navneet-krishna/Wireless_Lamp_Switch/fab/Receiver-3d-bottom.png

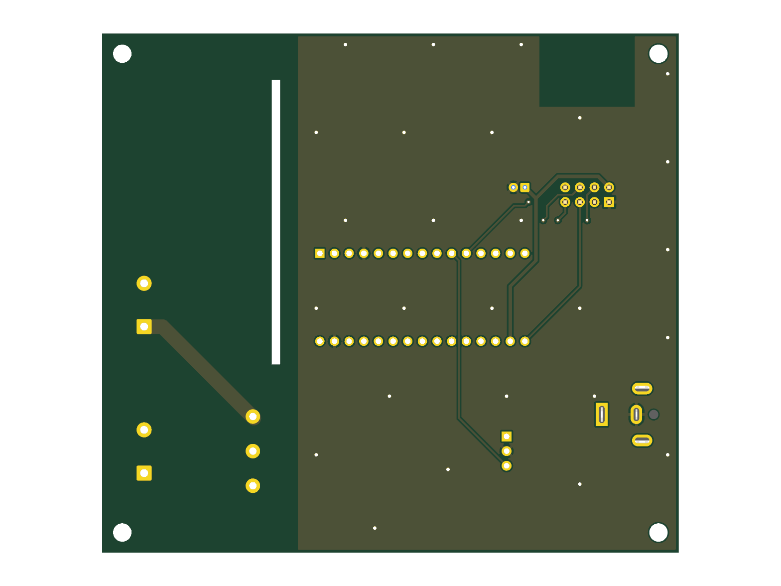
fab/Receiver-3d-bottom.png
