navneet-krishna/Wireless_Lamp_Switch/fab/Receiver-3d-top.png

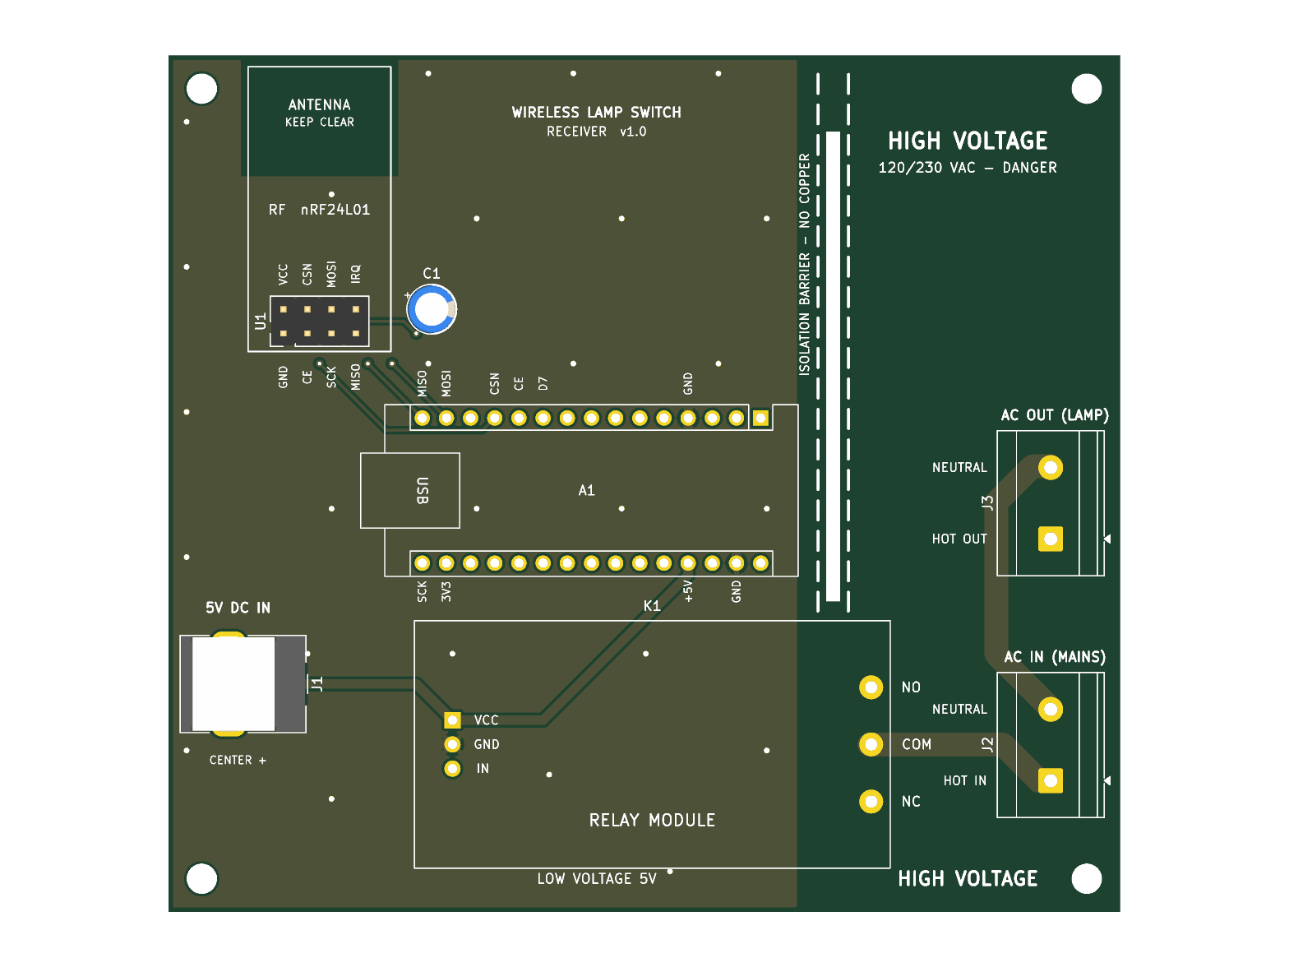
fab/Receiver-3d-top.png
