navneet-krishna/Wireless_Lamp_Switch/fab/Transmitter-3d-bottom.png

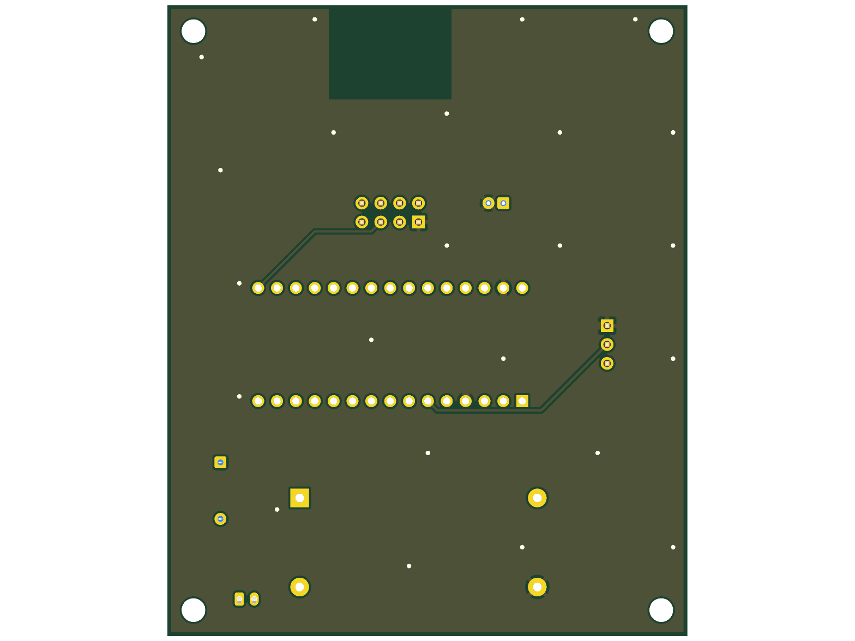
fab/Transmitter-3d-bottom.png
