navneet-krishna/Wireless_Lamp_Switch/fab/Transmitter-3d-top.png

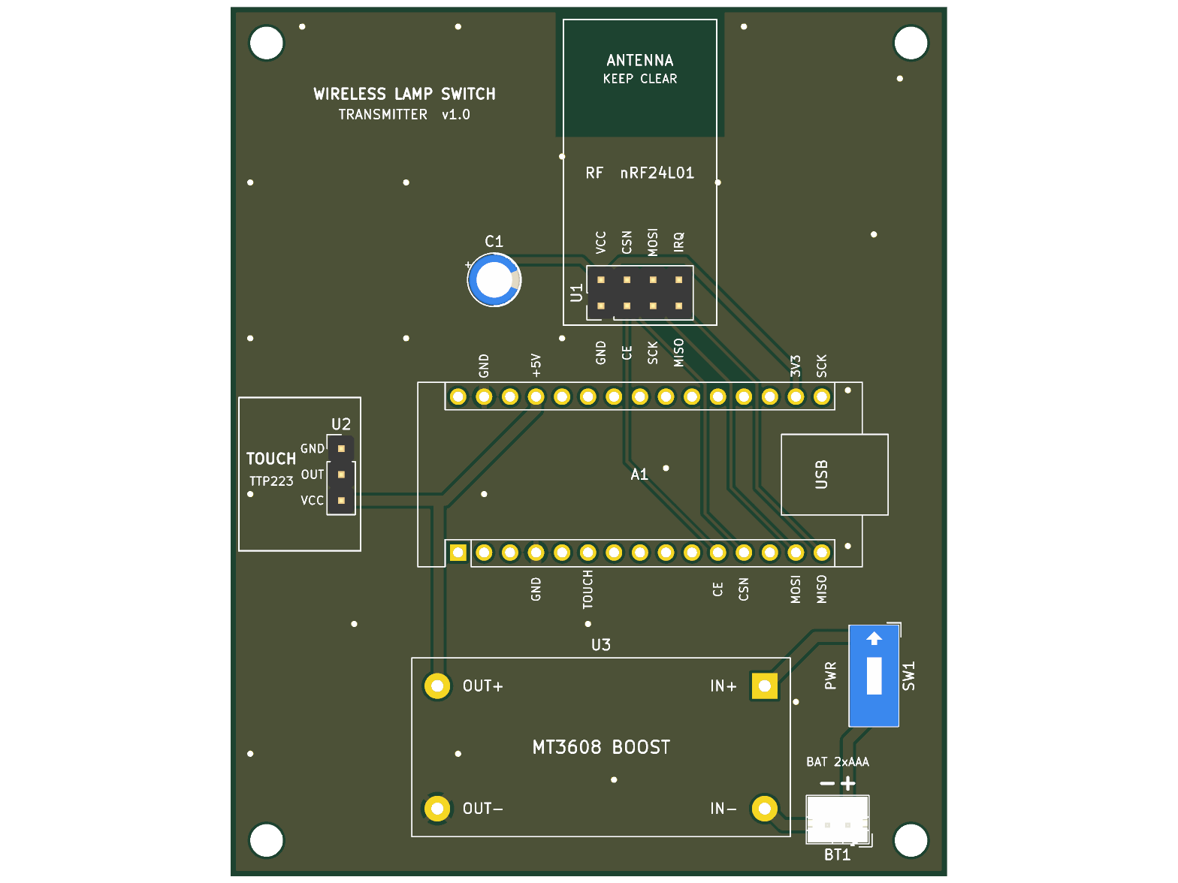
fab/Transmitter-3d-top.png
