navneet-krishna/Wireless_Lamp_Switch/fab/Receiver-schematic.pdf

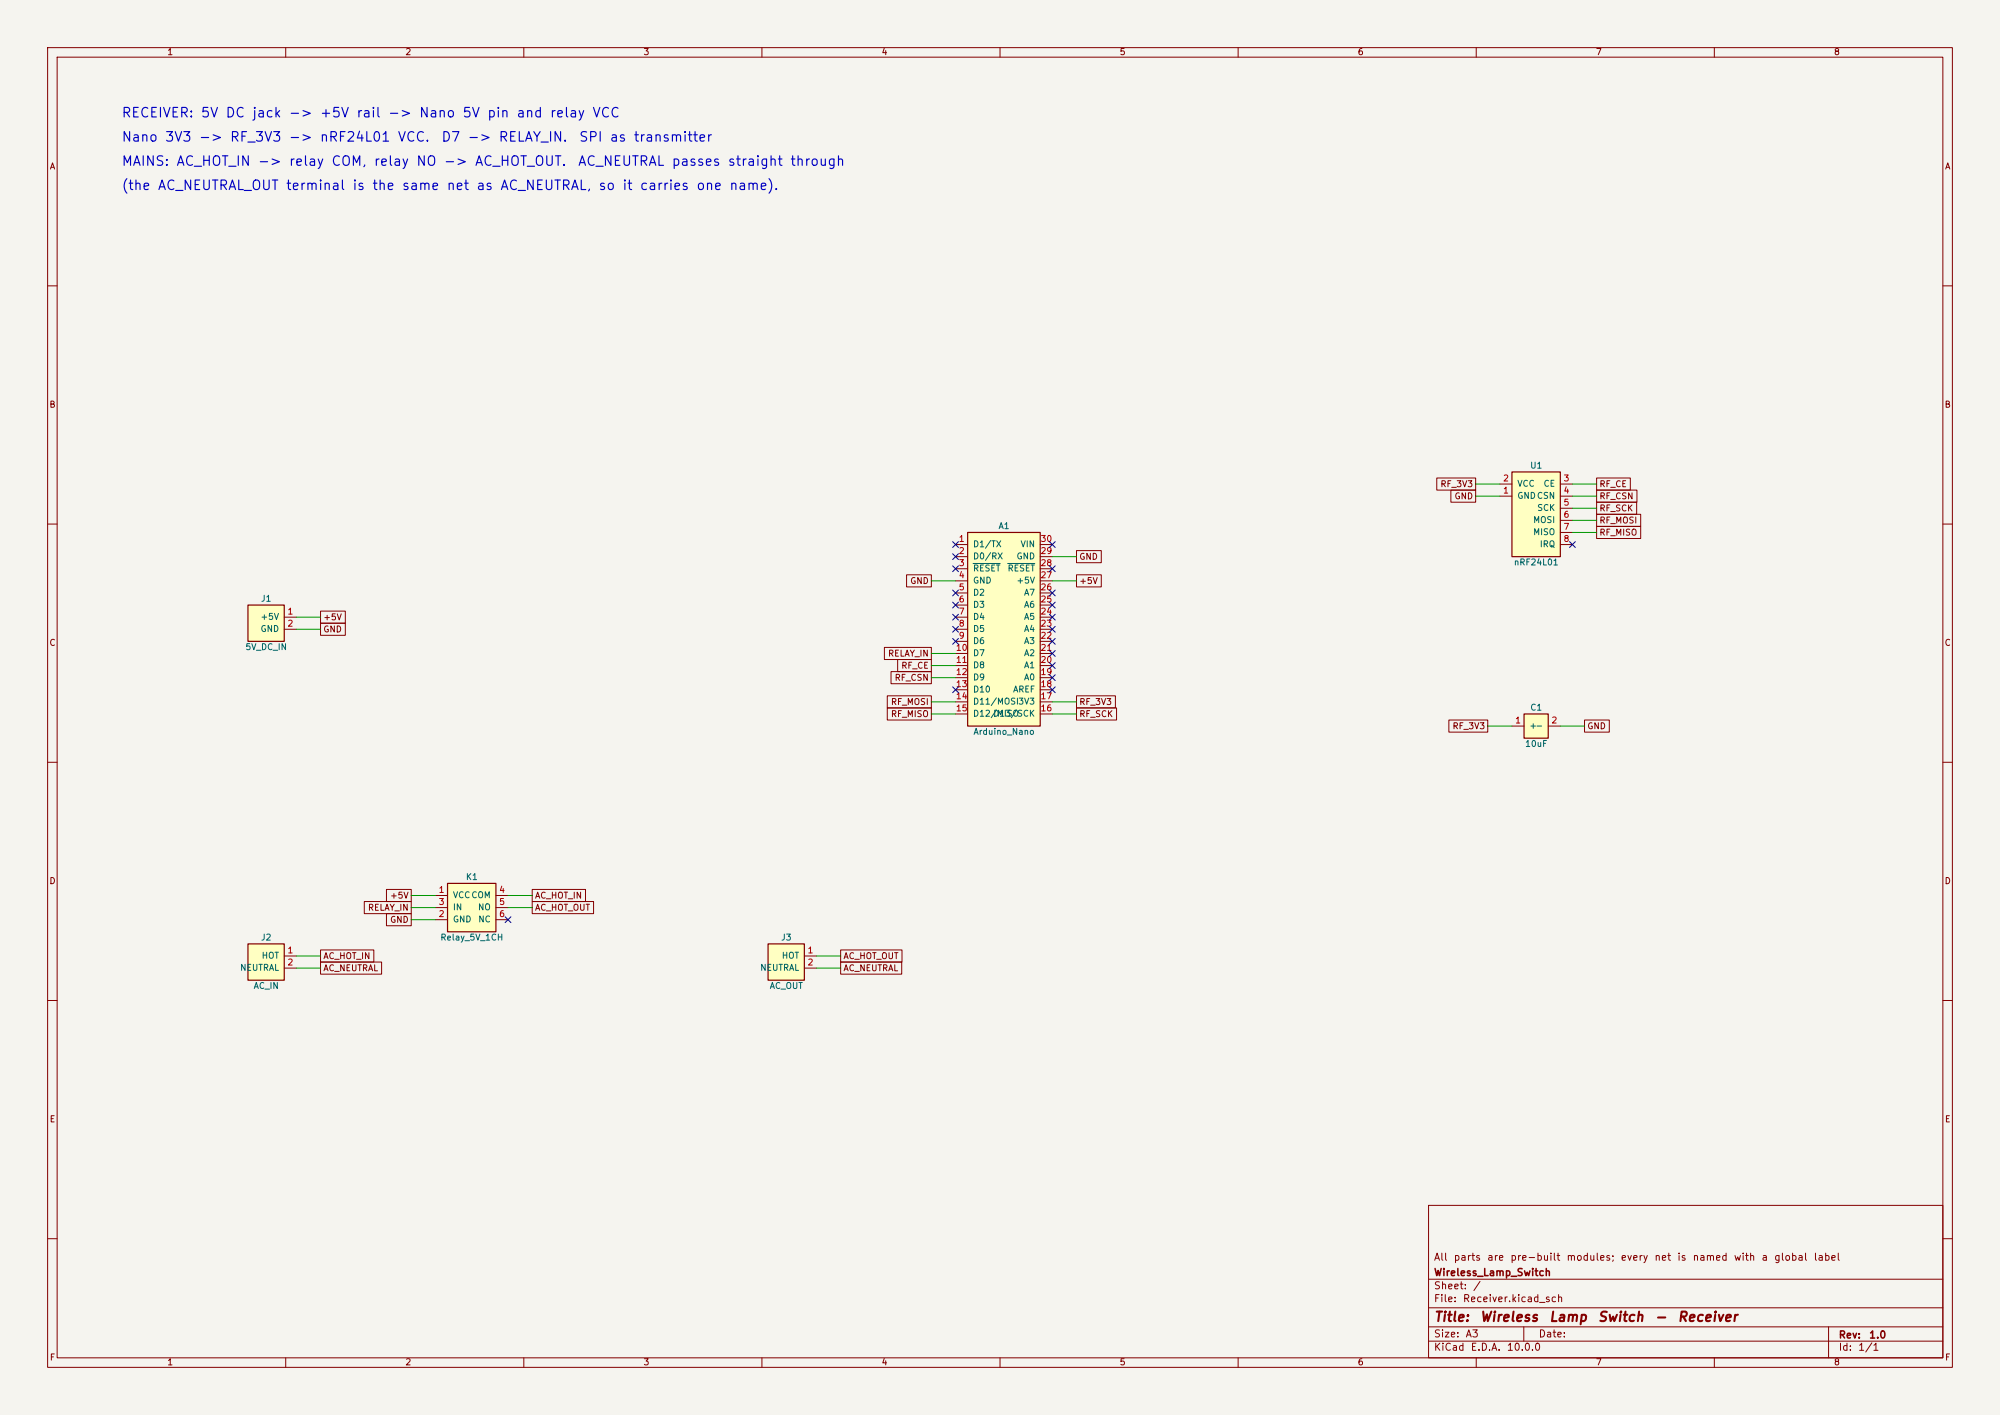
[picture p5: page 1]

RECEIVER: 5V DC jack -> +5V rail -> Nano 5V pin and relay VCC

All parts are pre-built modules; every net is named with a global label
Wireless_Lamp_Switch
Sheet: /
File: Receiver.kicad_sch
Title: Wireless Lamp Switch - Receiver

Size: A3 | Rev: 1.0 | F Date:
KiCad E.D.A. 10.0.0 | Id: 1/1
