navneet-krishna/Wireless_Lamp_Switch/fab/Receiver-top-assembly.pdf

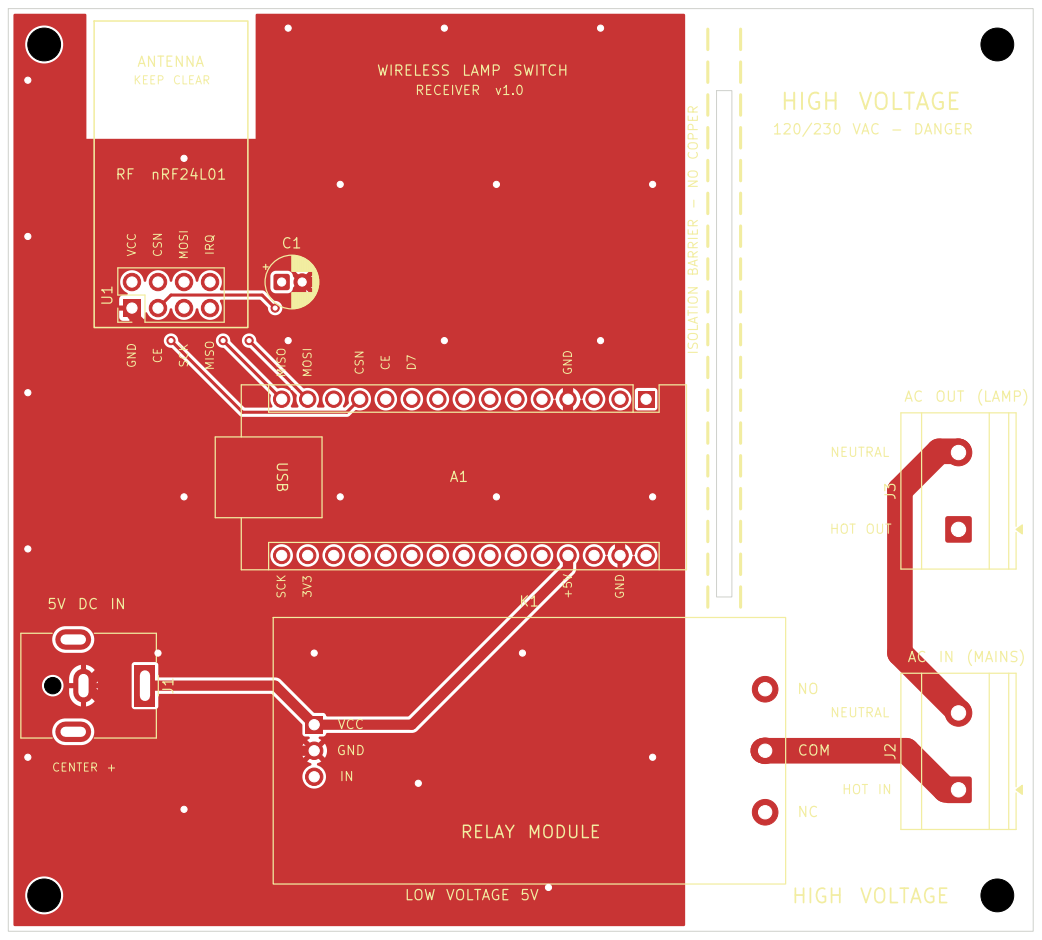
[picture p6: page 1]

ANTENNA RF nRF24L01
AC OUT (LAMP) AC IN (MAINS) HIGH VOLTAGE HIGH VOLTAGE
