navneet-krishna/Wireless_Lamp_Switch/fab/Transmitter-schematic.pdf

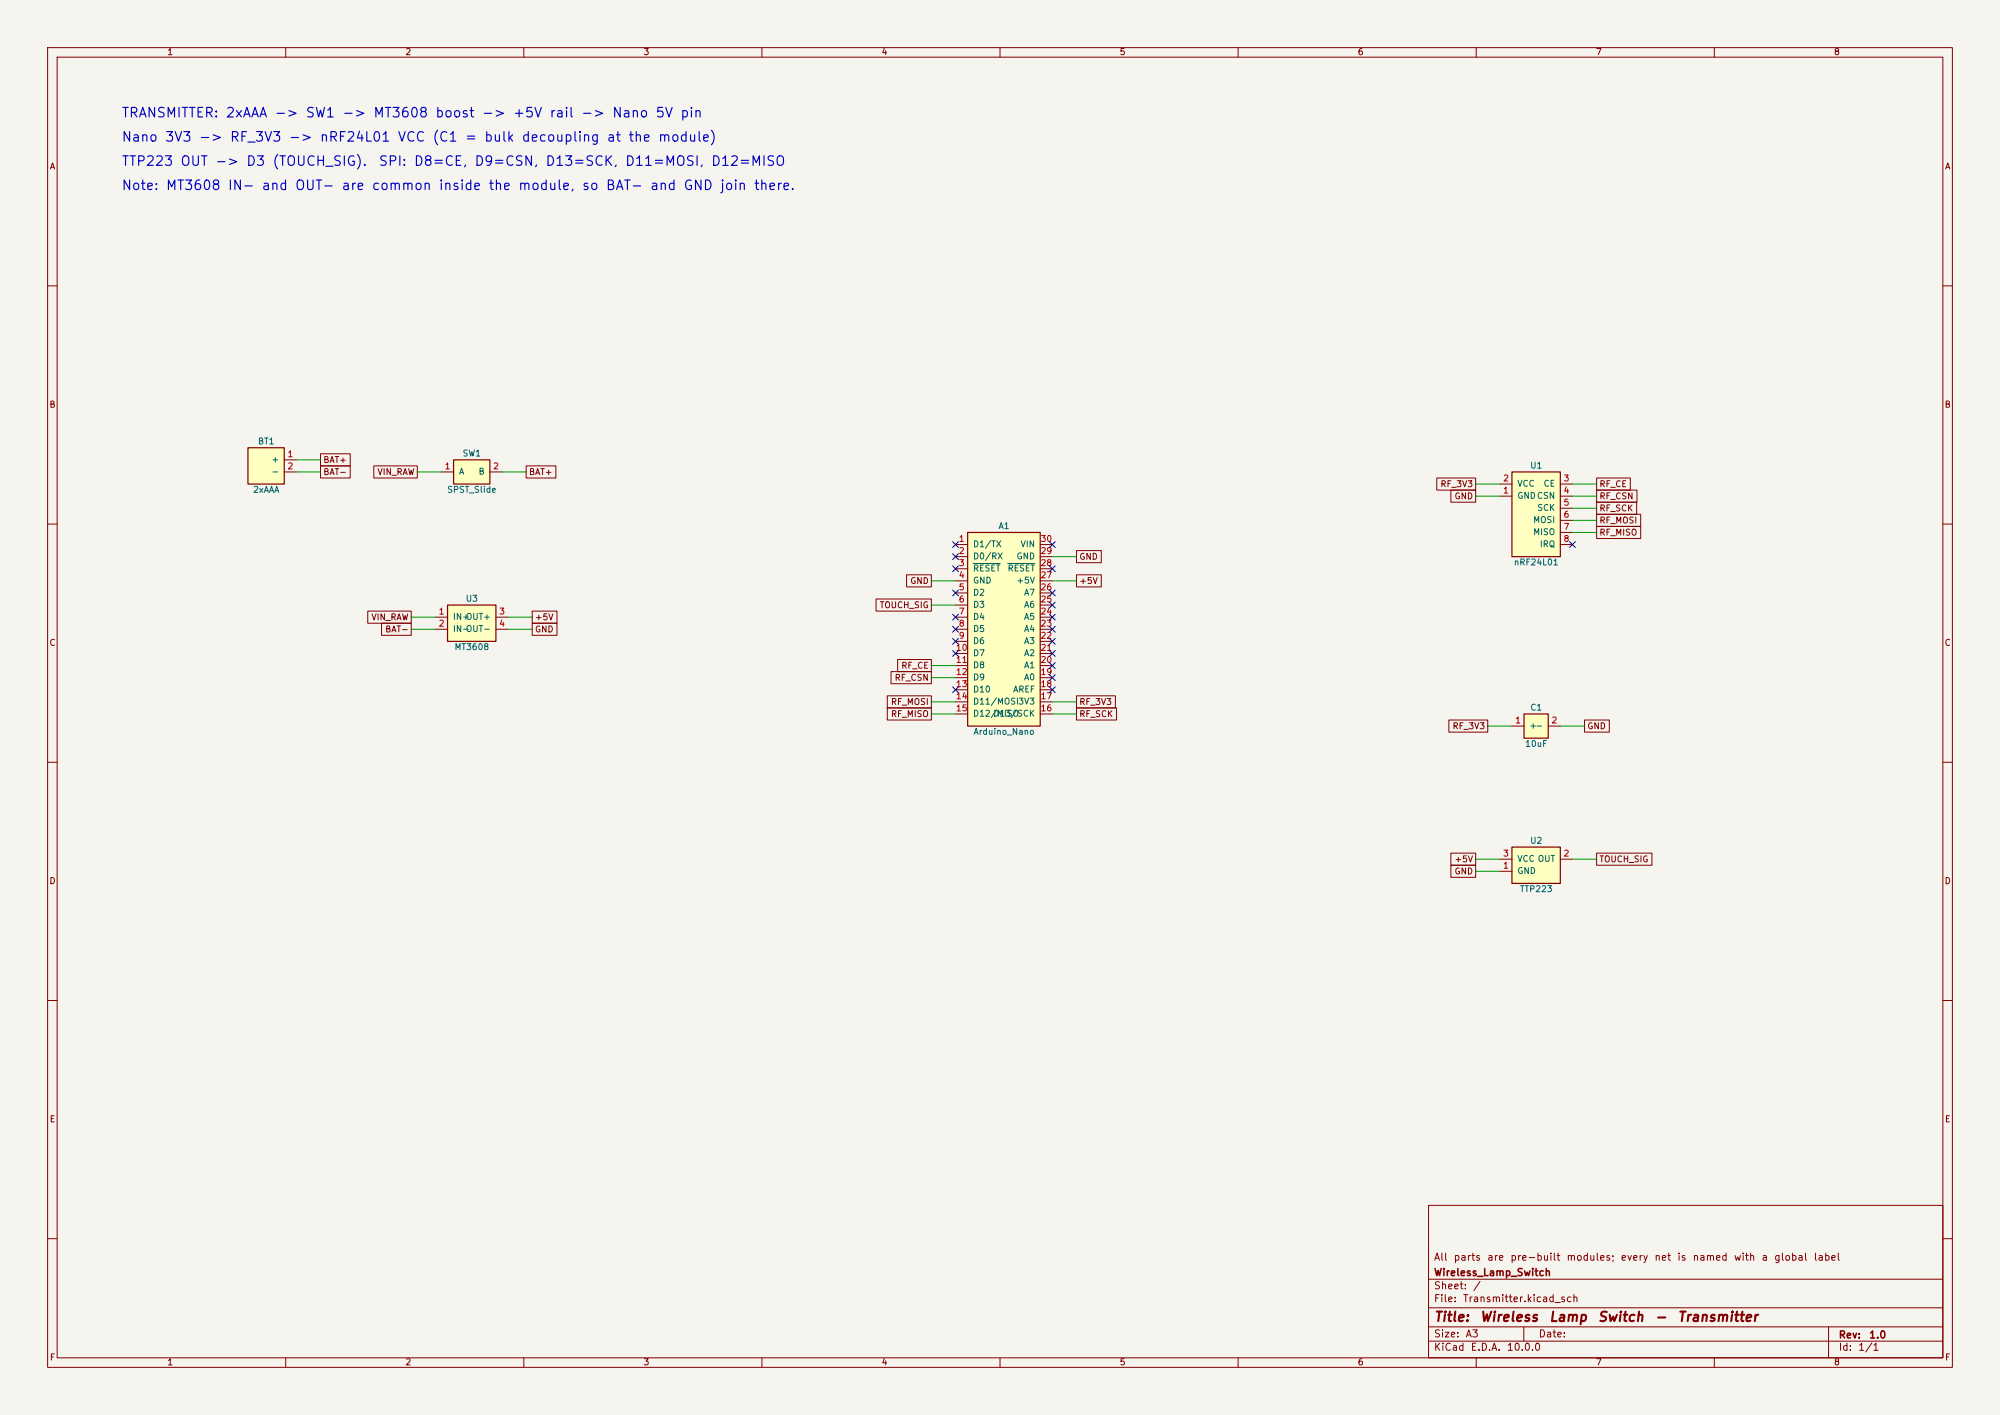
[picture p7: page 1]

TRANSMITTER: 2xAAA -> SW1 -> MT3608 boost -> +5V rail -> Nano 5V pin
Nano 3V3 -> RF_3V3 -> nRF24L01 VCC (C1 = bulk decoupling at the module)

All parts are pre-built modules; every net is named with a global label
Wireless_Lamp_Switch
Sheet: /
File: Transmitter.kicad_sch
Title: Wireless Lamp Switch - Transmitter

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
