navneet-krishna/Wireless_Lamp_Switch/fab/Transmitter-top-assembly.pdf

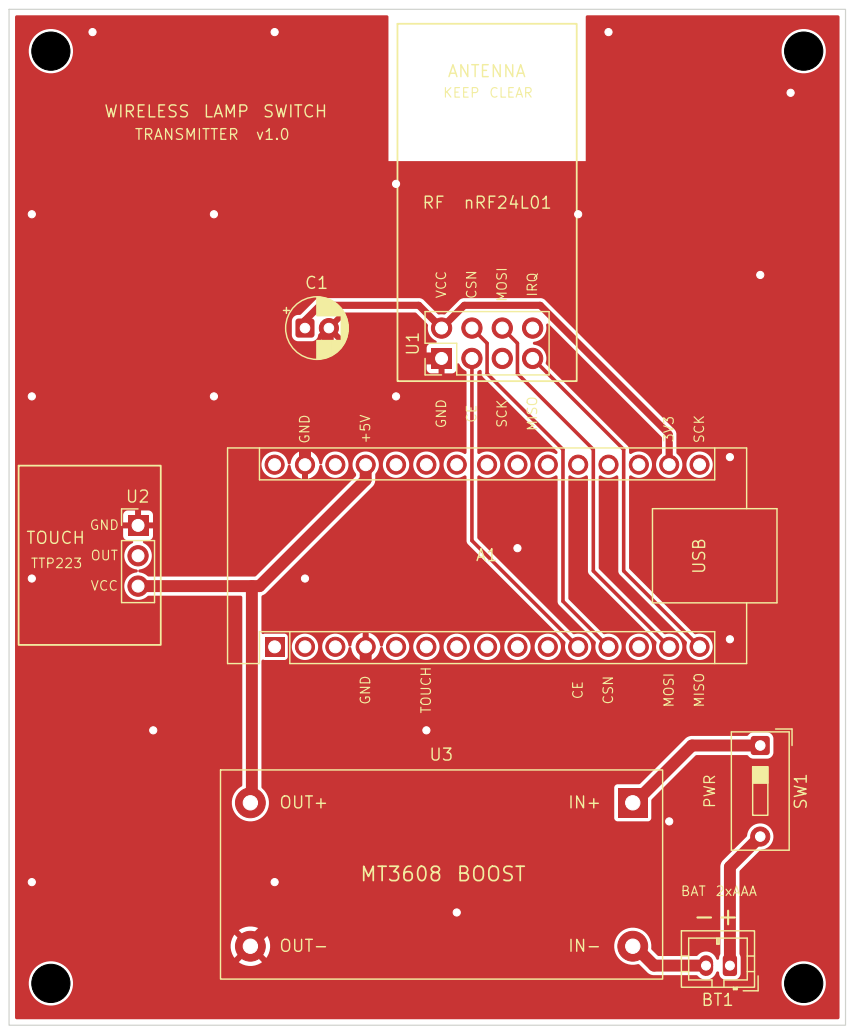
[picture p8: page 1]
