navneet-krishna/Wireless_Lamp_Switch/Receiver.kicad_pcb

## KiCad design Receiver.kicad_pcb (2026-10-19)

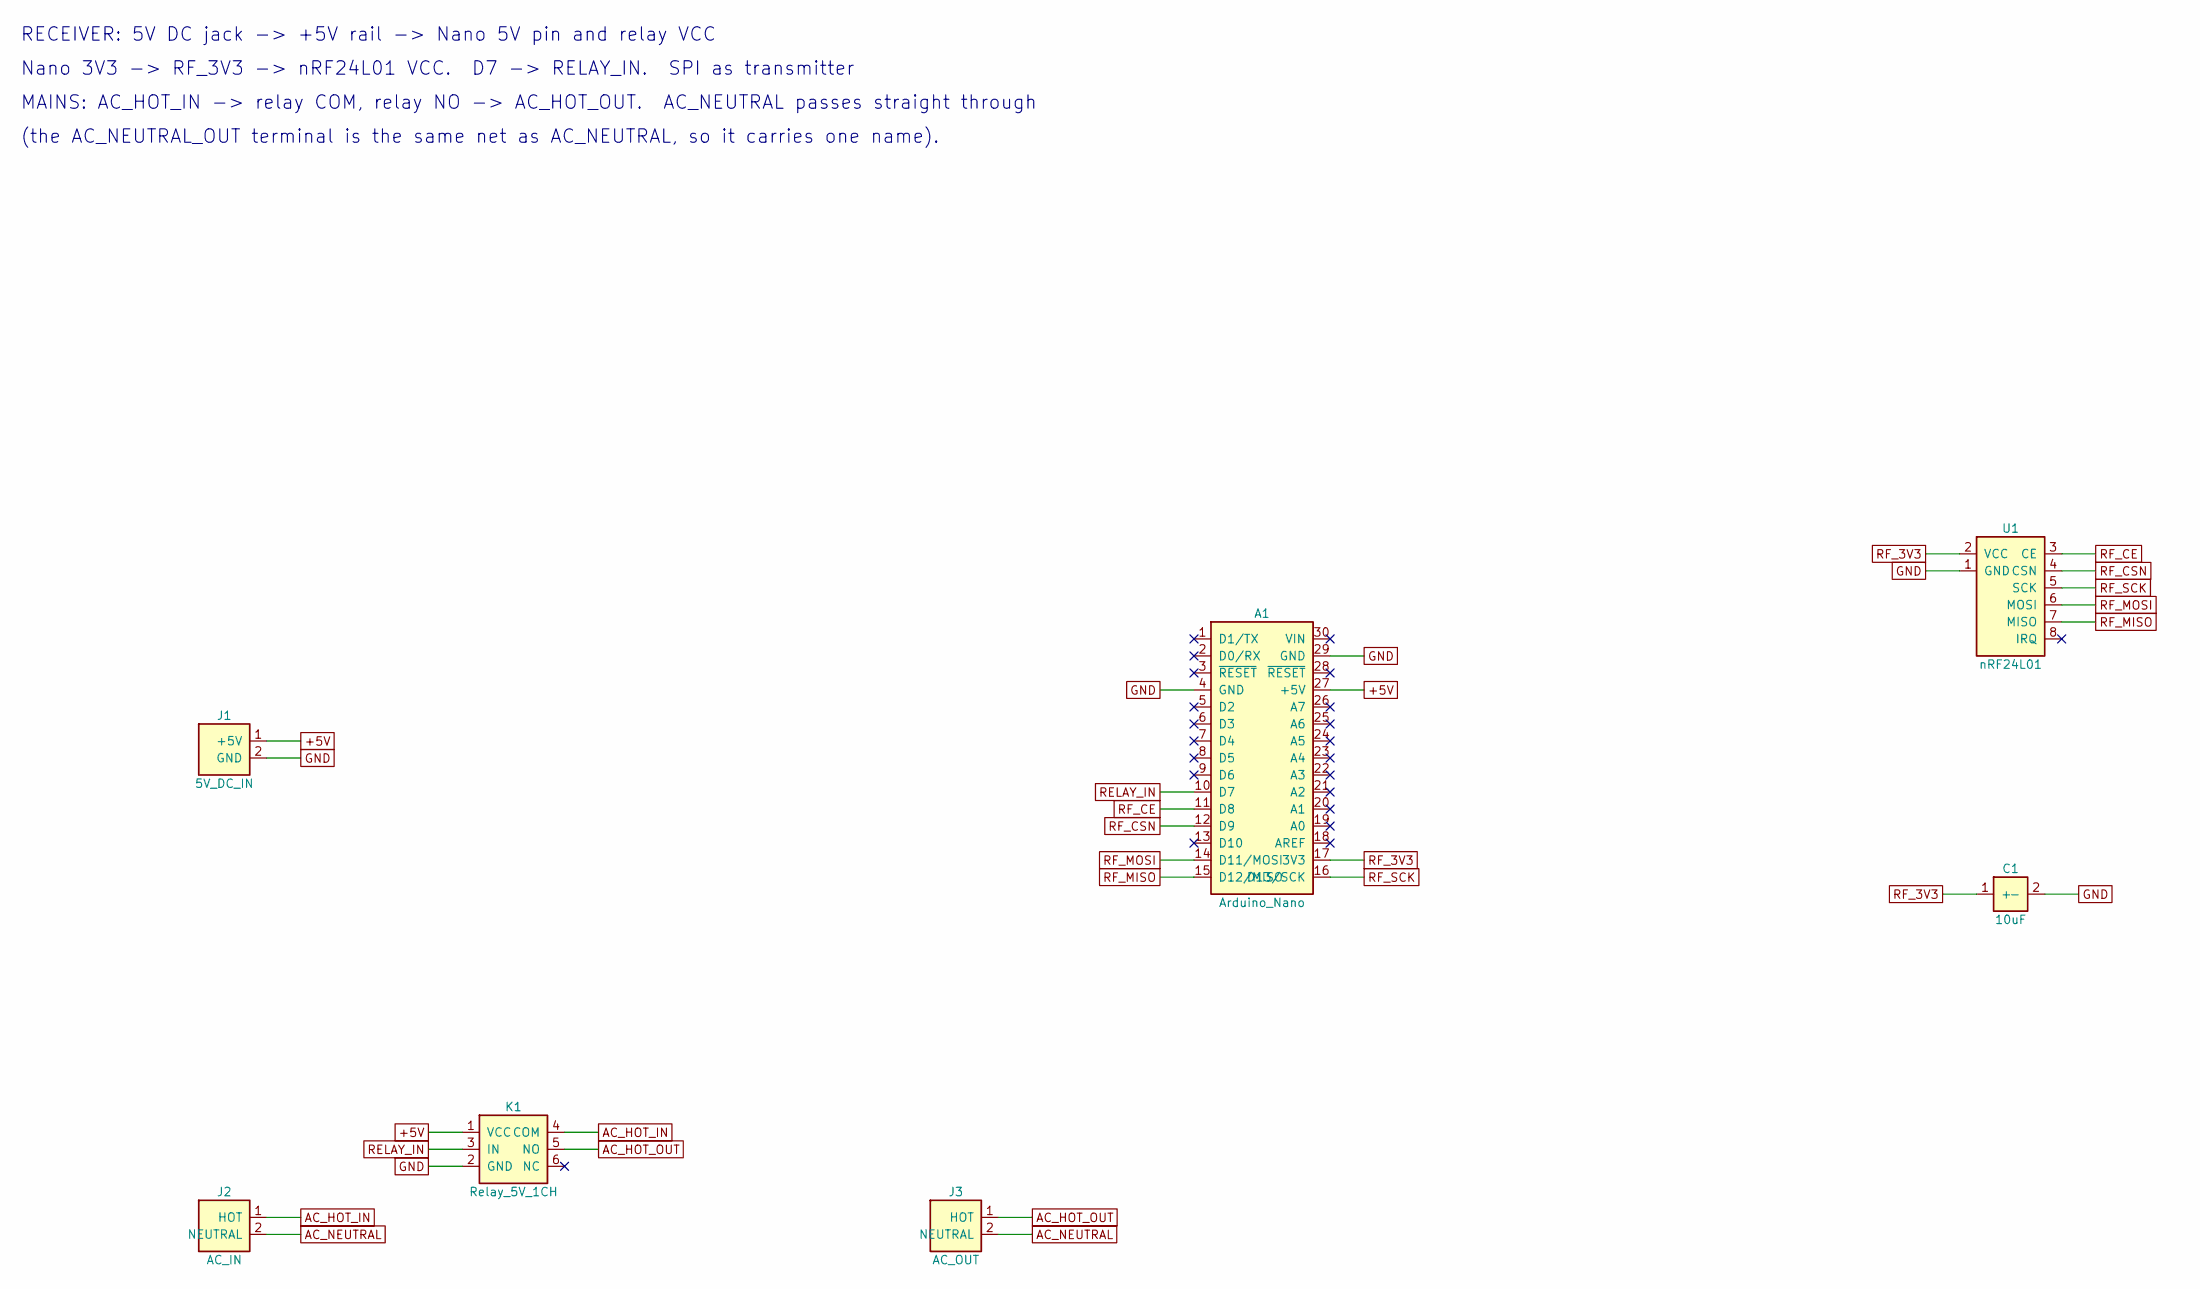
[picture p9: schematic Receiver.kicad_sch, Wireless Lamp Switch - Receiver]

Parts:
A1: Arduino_Nano
C1: 10uF; CP_Radial_D5.0mm_P2.00mm
J1: 5V_DC_IN; BarrelJack_CUI_PJ-063AH_Horizontal
J2: AC_IN; TerminalBlock_MetzConnect_Type175_RT02702HBLC_1x02_P7.50mm_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
J3: AC_OUT; TerminalBlock_MetzConnect_Type175_RT02702HBLC_1x02_P7.50mm_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
K1: Relay_5V_1CH; Relay_Module_1CH
U1: nRF24L01; PinHeader_2x04_P2.54mm_Vertical

Connections:
+5V: A1.27 (+5V), J1.1 (+5V), K1.1 (VCC)
AC_HOT_IN: J2.1 (HOT), K1.4 (COM)
AC_HOT_OUT: J3.1 (HOT), K1.5 (NO)
AC_NEUTRAL: J2.2 (NEUTRAL), J3.2 (NEUTRAL)
GND: A1.4 (GND), A1.29 (GND), C1.2 (-), J1.2 (GND), K1.2 (GND), U1.1 (GND)
RELAY_IN: A1.10 (D7), K1.3 (IN)
RF_3V3: A1.17 (3V3), C1.1 (+), U1.2 (VCC)
RF_CE: A1.11 (D8), U1.3 (CE)
RF_CSN: A1.12 (D9), U1.4 (CSN)
RF_MISO: A1.15 (D12/MISO), U1.7 (MISO)
RF_MOSI: A1.14 (D11/MOSI), U1.6 (MOSI)
RF_SCK: A1.16 (D13/SCK), U1.5 (SCK)

Notes on the sheet:
(the AC_NEUTRAL_OUT terminal is the same net as AC_NEUTRAL, so it carries one name).
Nano 3V3 -> RF_3V3 -> nRF24L01 VCC. D7 -> RELAY_IN. SPI as transmitter
RECEIVER: 5V DC jack -> +5V rail -> Nano 5V pin and relay VCC
MAINS: AC_HOT_IN -> relay COM, relay NO -> AC_HOT_OUT. AC_NEUTRAL passes straight through

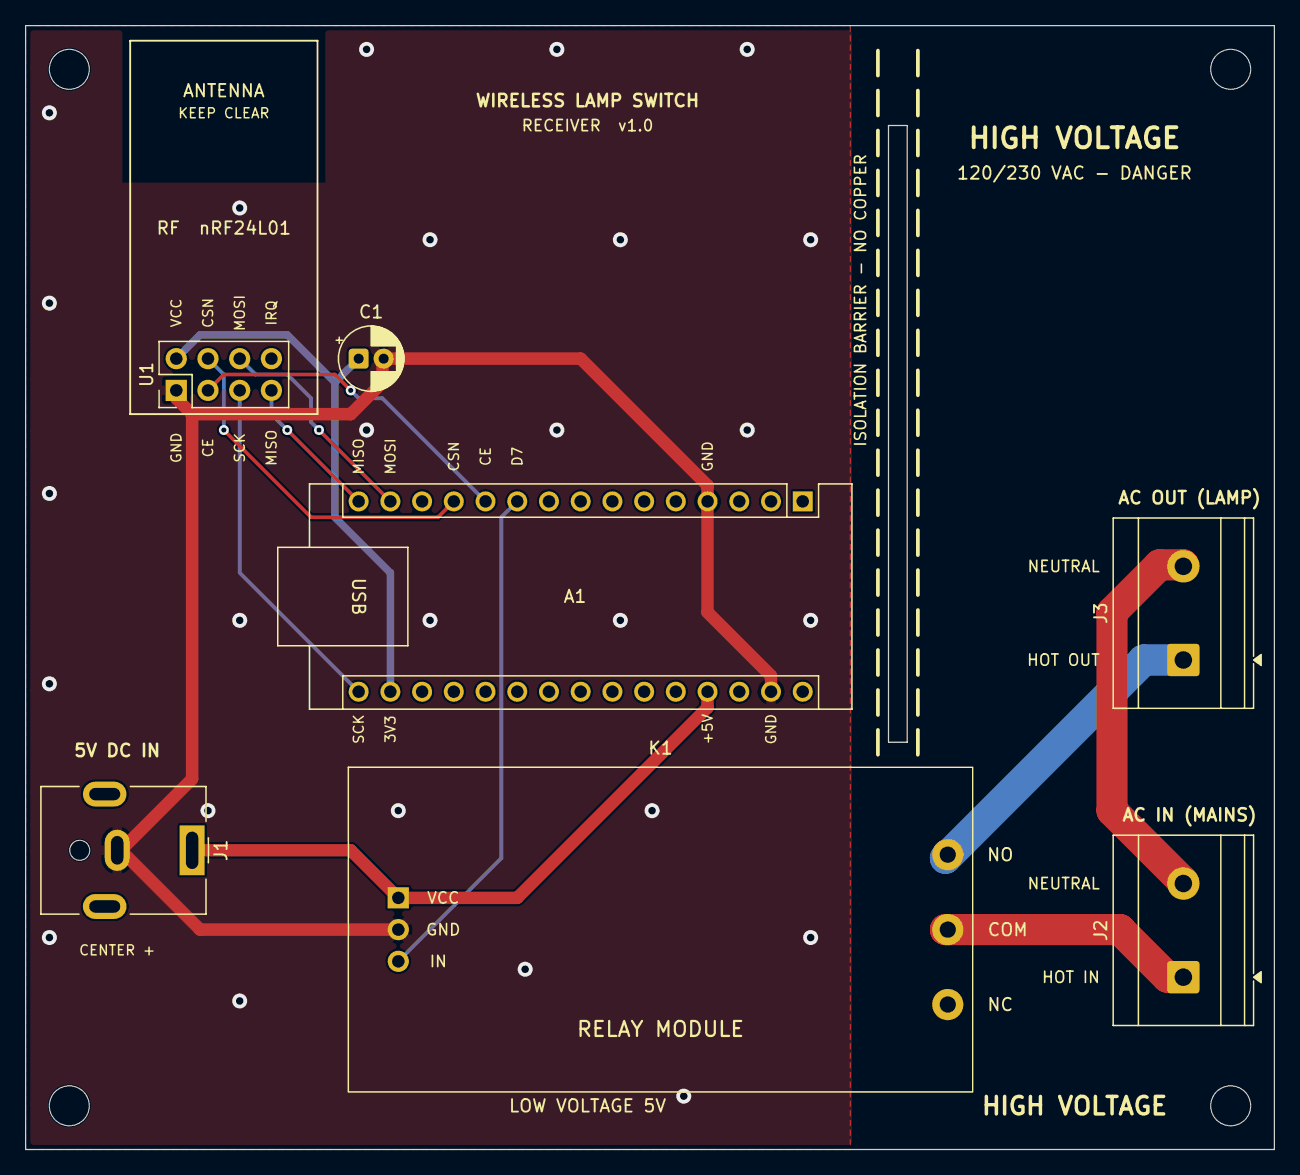
[picture p10: board Receiver.kicad_pcb from above]

Board: 2 copper layers, 100.0 x 90.0 mm, 11 parts (0 on the bottom side), 12 nets.

Other parts of the board:
H1, H2, H3, H4: M3; MountingHole_3.2mm_M3
